srgordo2005-dev/fabricamaquete/BetSmarterHub_extracted/src/assets/bg-pattern.jpg

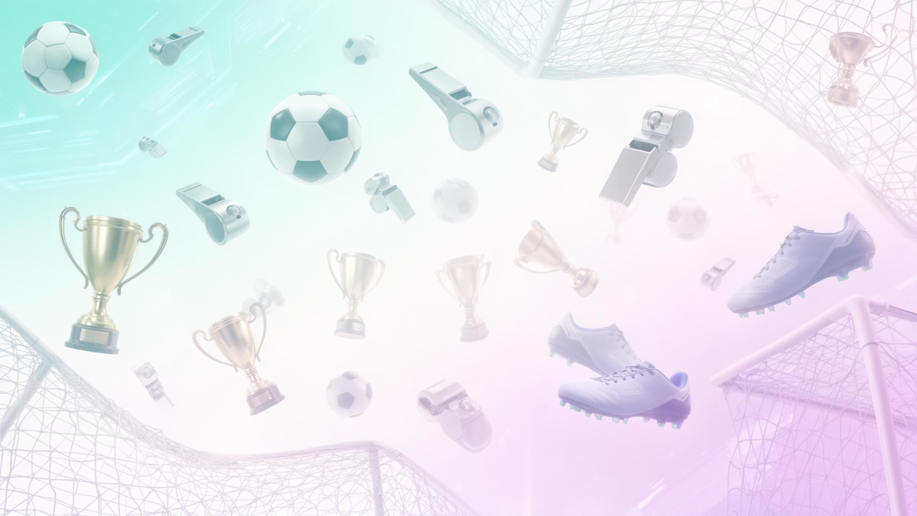
BetSmarterHub_extracted/src/assets/bg-pattern.jpg
