srgordo2005-dev/fabricamaquete/pecas_impressao/base_inferior_traseira.3mf

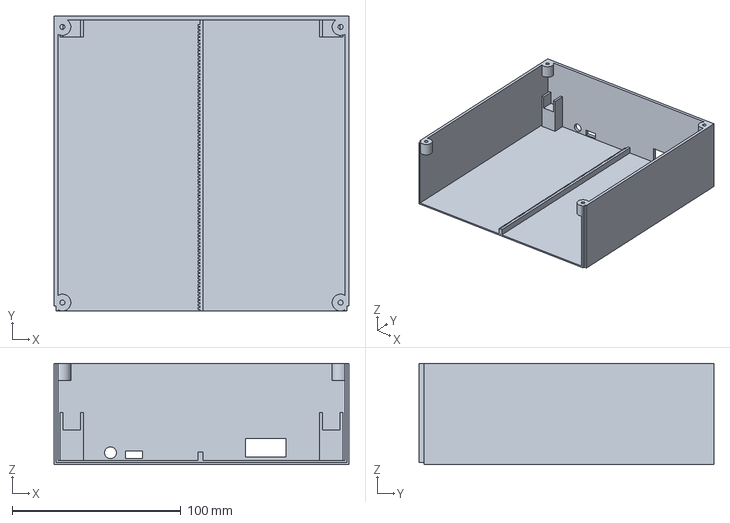
[picture p2: CAD file, 2026-08-15]
pecas_impressao/base_inferior_traseira.3mf
175.0 x 175.0 x 60.0 mm
