srgordo2005-dev/fabricamaquete/PROJETO.3mf

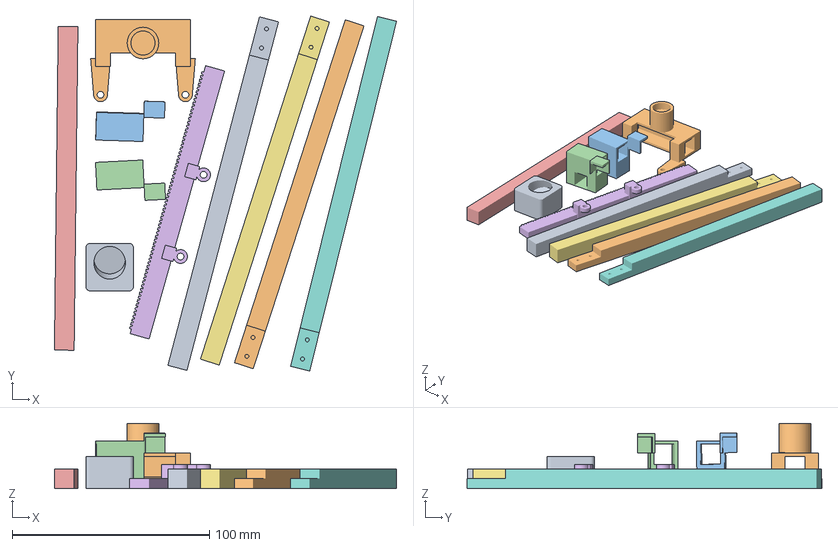
[picture p3: CAD file, 2026-08-15]
PROJETO.3mf
173.3 x 179.8 x 33.0 mm
acessorio_dedal.stl
carrinho_central_x.stl
carrinho_lateral_y_direito.stl
carrinho_lateral_y_esquerdo.stl
eixo_x_barra.stl
ponte_movel_x.stl
eixo_y_barra_frontal.stl x 2
eixo_y_barra_traseira.stl x 2
