srgordo2005-dev/fabricamaquete/pecas_impressao/carrinho_lateral_y_esquerdo.stl

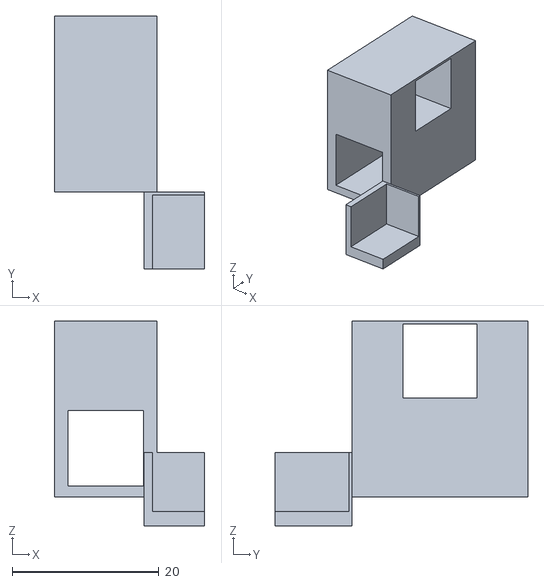
[picture p4: CAD file, 2026-08-15]
pecas_impressao/carrinho_lateral_y_esquerdo.stl
20.5 x 34.5 x 27.9
