srgordo2005-dev/fabricamaquete/pecas_impressao/tampa_superior_traseira.3mf

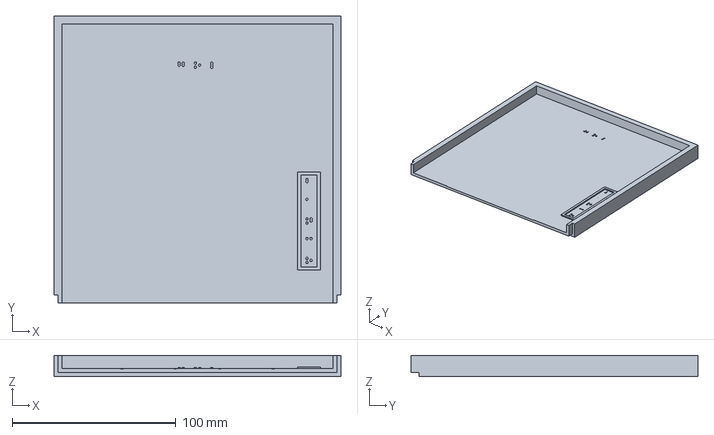
[picture p6: CAD file, 2026-08-15]
pecas_impressao/tampa_superior_traseira.3mf
175.0 x 175.0 x 13.0 mm
