srgordo2005-dev/fabricamaquete/pecas_impressao/eixo_y_barra_frontal.stl

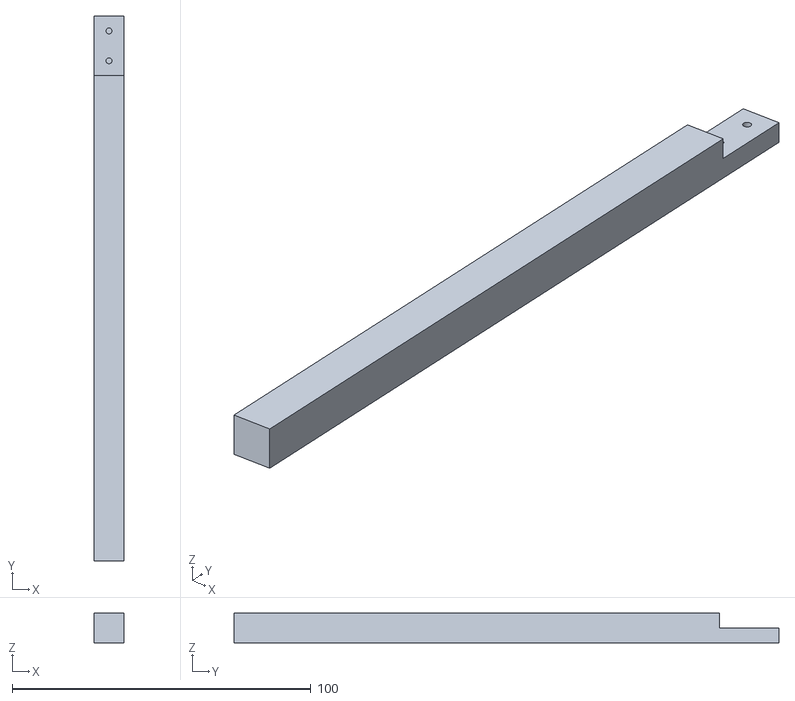
[picture p7: CAD file, 2026-08-15]
pecas_impressao/eixo_y_barra_frontal.stl
10.0 x 182.5 x 10.0
