srgordo2005-dev/fabricamaquete/pecas_impressao/ponte_movel_x.stl

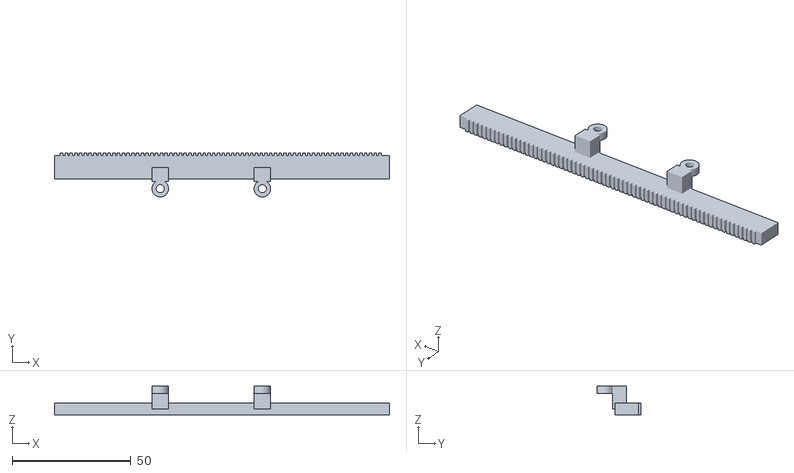
[picture p8: CAD file, 2026-08-15]
pecas_impressao/ponte_movel_x.stl
141.0 x 18.5 x 12.0
