srgordo2005-dev/fabricamaquete/pecas_impressao/carrinho_central_x.stl

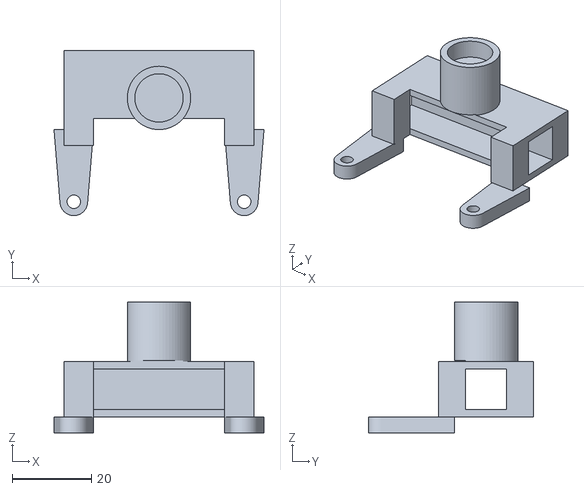
[picture p9: CAD file, 2026-08-15]
pecas_impressao/carrinho_central_x.stl
53.0 x 41.7 x 33.0
