srgordo2005-dev/fabricamaquete/pecas_impressao/eixo_x_barra.stl

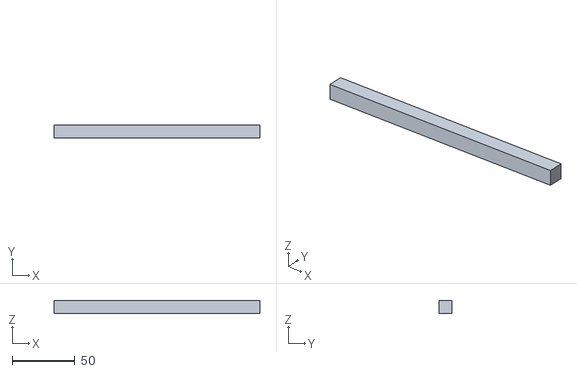
[picture p10: CAD file, 2026-08-15]
pecas_impressao/eixo_x_barra.stl
164.0 x 10.0 x 10.0
