srgordo2005-dev/fabricamaquete/pecas_impressao/acessorio_dedal.stl

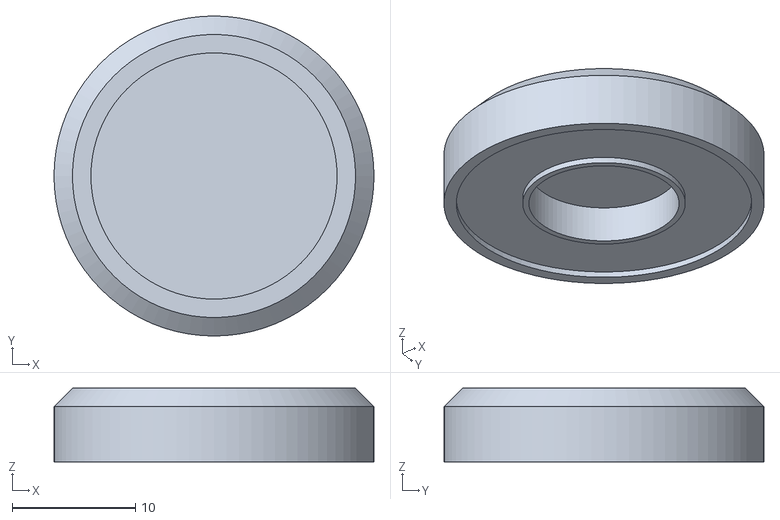
[picture p11: CAD file, 2026-08-15]
pecas_impressao/acessorio_dedal.stl
26.0 x 26.0 x 6.00
