srgordo2005-dev/fabricamaquete/pecas_impressao/pinos_encaixe_tampa.stl

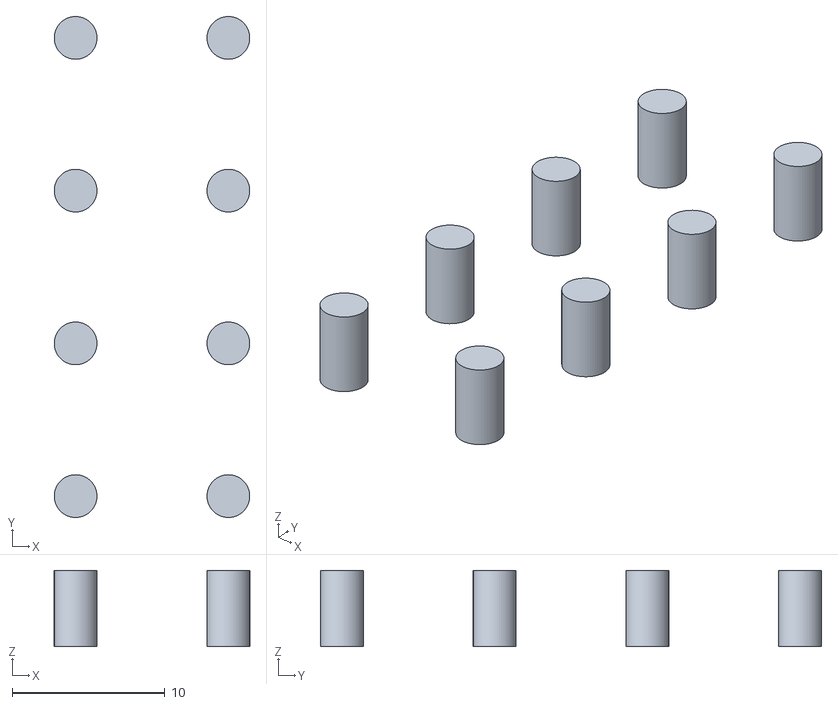
[picture p12: CAD file, 2026-08-15]
pecas_impressao/pinos_encaixe_tampa.stl
12.8 x 32.8 x 5.00
