srgordo2005-dev/fabricamaquete/(list of files, cad)

Other CAD files:
pecas_impressao/carrinho_lateral_y_direito.stl
pecas_impressao/base_inferior_frontal.3mf
pecas_impressao/eixo_y_barra_traseira.stl
base_inferior_frontal.scad
base_inferior_traseira.scad
carrinho_lateral_y_esquerdo.scad
eixo_y_barra_traseira.scad
montagem_completa.scad
tampa_superior_frontal.scad
tampa_superior_traseira.scad
pecas_impressao/base_inferior_frontal.stl
pecas_impressao/base_inferior_traseira.stl
pecas_impressao/tampa_superior_frontal.stl
pecas_impressao/tampa_superior_traseira.stl
