srgordo2005-dev/fabricamaquete/manual_projeto.html

# Manual Técnico de Engenharia & Montagem

Projeto Campo Tátil: Maquete de Futebol Portátil para Deficientes Visuais

## 1. 📐 Medidas e Especificações Mecânicas Gerais

Componente / Elemento | Dimensão Oficial | Função Principal
Gabinete Inferior (Carcaça) | 240mm (X) x 160mm (Y) x 26mm (Z) | Base de proteção física e suporte eletrônico.
Tampa Superior (Campo) | 240mm (X) x 160mm (Y) x 1.5mm (Espessura) | Espessura de 1.5mm garante arraste magnético perfeito.
Marcações Táteis do Campo | +1.2mm de altura em relevo | Linhas de fundo, laterais e áreas para segunda mão.
Hastes Eixo Y (2 unidades) | Haste lisa de aço de 8mm (140mm de comprimento) | Guias lineares do portal móvel da maquete.
Haste Eixo X (1 unidade) | Haste lisa de aço de 8mm (220mm de comprimento) | Guia da ponte móvel que suporta o carrinho do ímã.
Ímã de Neodímio | N52 de 12mm x 3mm (Cilindro) | Tração magnética através do plástico do campo.
Motores de Passo (2x) | NEMA 14 Pancake (Diâmetro 36.5mm / Altura ~17mm) | Movimentação cartesiana leve e compacta.

## 2. 🔌 Esquema de Fiação e Pinagem do ESP32-S3

Ligue todos os cabos nas portas de controle de acordo com a tabela abaixo:

Componente | Pino do Módulo | GPIO correspondente no ESP32-S3 | Observação
Driver TMC2208 (X) | STEP / DIR / EN | GPIO 11 / GPIO 12 / GPIO 10 | Controla o motor do carrinho do Eixo X.
Driver TMC2208 (Y) | STEP / DIR / EN | GPIO 13 / GPIO 14 / GPIO 9 | Controla o motor da ponte do Eixo Y.
Áudio DAC MAX98357A | BCLK / LRC / DIN | GPIO 15 / GPIO 16 / GPIO 17 | Conexão digital I2S de som limpo.
Medidor de Carga | Pino ADC (Analógico) | GPIO 4 (com Divisor de 2 Resistores 10k) | Mede a tensão para o aviso de voz de bateria.
Motor de Vibração | Porta de Sinal PWM | GPIO 18 (ligado no Transistor NPN) | Dispara os pulsos de GOL ou falta.

ESQUEMA DE LIGAÇÃO DE ÁUDIO AUTOMÁTICO (FONE E ALTO-FALANTE): [ Saída MAX98357A (+) ] -----------> [ Pino 2 e 3 do P2 Jack PJ-307 ] (Som unificado L+R) [ Saída MAX98357A (-) ] -----------> [ Pino 1 do P2 Jack PJ-307 ] (GND / Comum) [ Pino 4 do P2 (Chave) ] ----------> [ Terminal (+) do Alto-falante de 3W ] [ Saída MAX98357A (-) ] -----------> [ Terminal (-) do Alto-falante de 3W ]

## 3. 🛠️ Guia de Montagem Passo a Passo

1 Limpeza das Buchas 3D: Lixe levemente o furo interno das buchas deslizantes impressas em 3D em PETG. Passe um pouco de graxa de silicone ou cole fita PTFE (Teflon) dentro para que elas deslizem nas hastes de 8mm de aço com suavidade e sem fazer ruído.

2 Montagem do Portal Y (A Ponte): Insira os dois Carrinhos Y Laterais nas hastes guia Y da caixa. Insira a haste de metal X (ponte) sob pressão entre os dois carrinhos laterais. Verifique se a ponte desliza para frente e para trás de forma livre.

3 Montagem do Carrinho Central X: Insira o Carrinho Central X na haste central de metal. Coloque o ímã de neodímio 12x3mm no topo do carrinho (virado para cima) e cole o mini motor de vibração de 10mm no bolso inferior do ímã.

4 Tensionamento das Correias: Passe a correia GT2 de 6mm por baixo dos carrinhos Y laterais e trave os dentes da correia nas garras. Estique a correia até a polia louca na frente e ao pinhão do motor NEMA 14 na traseira. A correia deve ficar firme, sem balançar.

5 Instalação da Placa Tipo-C e Tela LCD: Encaixe a placa carregadora 15W Tipo-C e o Visor LCD de bateria nos trilhos de guia na frente da carcaça. Eles vão deslizar até encostar na parede, alinhando as portas Tipo-C e o painel nos furos que projetamos.

ℹ️ Como salvar este manual em PDF:
Pressione Ctrl + P no seu teclado (ou Cmd + P no Mac), escolha o destino "Salvar como PDF" e clique em Salvar!
