srgordo2005-dev/fabricamaquete/(commit log)

2026-08-15 Initial commit: Tactile Soccer Maquette Integrated System
    [PROJETO.3mf, acessorio_dedal.scad, acessorio_dedal.stl, base_inferior.scad, base_inferior_frontal.3mf, base_inferior_frontal.scad, base_inferior_frontal.stl, base_inferior_traseira.3mf]
2026-08-15 Phase 2: Integrate resulta. rebrand, acessivel-ja features, voice search, and Google Ads slots
2026-08-16 Fix NEMA 14 motor hole spacing and alignments in CAD pieces (Carrinho X, Cremalheira X, and Ponte X)
    [carrinho_central_x.scad, cremalheira_x.scad, montagem_completa.scad, ponte_movel_x.scad]
2026-08-16 Fix CAD files for round NEMA 14 pancake motor with 46mm hole spacing
    [carrinho_central_x.scad, montagem_completa.scad, ponte_movel_x.scad, suporte_motor_y.scad]
2026-08-16 Change bridge Y motor mount in CAD to a reinforced flat plate identical to carriage design
    [montagem_completa.scad, ponte_movel_x.scad]
2026-08-22 fix: add websocket broadcast relay and mac parsing for online status
    [carrinho_central_x.scad, cremalheira_x.scad, montagem_completa.scad, ponte_movel_x.scad, suporte_motor_y.scad]
